Yarick-Workshop/Walking-Dog-4-Paws/Dog-Utils.scad

module screw_hole(height, diameter, delta)
{
    cylinder(h = height + delta, d = diameter, center = true, $fn=360);
}
