Yarick-Workshop/Walking-Dog-4-Paws/(commit log)

2023-12-01 Removed all debug parts from the medium one (in the coordinates of the "paw-wheels")
    [Dog.scad]
2023-12-04 Added wheel spacers
    [Dog.scad]
2023-12-05 Hidden screw headers and nuts for wheel-paws shafts
    [Dog.scad]
2023-12-07 - Added screw nuts grooves (just on the right side – there will be grooves for screw heads on the left side); - Refactored logging of debug information; - Adjusted some argument values(screw header d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
    [Dog.scad]
2023-12-08 Added Producing type of rendering. There are two types: Preview and Producing. It is customizable by parameters
    [Dog.scad]
2023-12-12 Added test figures for testing customization of shaft diameter, screw nuts and headers. The figure is visible in "Producing" mode only
    [Dog.scad]
2023-12-16 Sizing adjustment for M3 screws and nuts & Solved problem of overheating test figures
    [Dog.scad]
2023-12-18 Sizing adjustment for M3 screws, nuts and shaft diameter
    [Dog.scad]
2023-12-18 Final (hope so) screw & shaft diameters adjustment
    [Dog.scad]
2023-12-25 Increased wheel spacer wall thickness, and added logging it's result value
    [Dog.scad]
2023-12-27 Enforced thin parts of the middle
    [Dog.scad]
2024-02-06 Wheel width is calculated from spacer and medium part (allow to have the wide wheels)
    [Dog.scad]
2024-02-06 Get rid of most relative Units of measure
    [Dog.scad]
2024-02-06 Added "Wheel width" and "Screw rod length" to debugging log; Refined debugging log in YAML-like style
    [Dog.scad]
2024-02-08 Wheel spacer is rendered in Producing mode just in case showWheels = true
    [Dog.scad]
2024-02-08 Adjusted hole sizes (for screws and shafts)
    [Dog.scad]
2024-02-08 Get rid of artifacts on preview for the wheel shaft customization figure
    [Dog.scad]
2024-02-08 Reduce filament usage for test figures
    [Dog.scad]
2024-02-09 Rounded values (except constants and adjustments) to xx.x
    [Dog.scad]
2024-02-10 Fixed wheel slicing problem with Prusa Slicer (a wheel with a built spacer was separating into 2 parts: spacer and wheel)
    [Dog.scad]
2024-02-22 Added assembly documentation to README.md
2024-02-24 Update README.md
    Added "Gel pen refill" info and ⌀ s
2024-02-27 Update README.md
    Added references to Prerendered STL-s on Thingiverse
2024-03-06 Added Side and Medium parts roundings with Cone and Sphere (With Minkowski)
    [Dog.scad]
2024-03-08 Increased convexity to have less artefacts; Added model rotating for Animation
    [Dog.scad]
2024-03-08 Possible to set currentHeight = 0
    [Dog.scad]
2024-03-15 Fixed mounting coords Xs for rounded model; Default rounding radius = 2.0.
    [Dog.scad]
2024-03-15 Fied formatting for mounting coords
    [Dog.scad]
2024-03-18 README.md: Added PTFE tube; Fixed drill bit info and filament amount
2024-04-19 Extracted Paws-Wheels related logic to an external library
    [Dog-Paw-Library.scad, Dog.scad]
2024-04-19 Extracted the medium part related logic to an external library
    [Dog-Medium-Library.scad, Dog.scad]
2024-04-19 Converted Dog-Paw-Library to a context independent module
    [Dog-Paw-Library.scad, Dog.scad]
2024-04-19 Fixed hiding Paws in Preview mode
    [Dog.scad]
2024-04-19 Converted Dog-Medium-Library to a context independent module
    [Dog-Medium-Library.scad, Dog-Utils.scad, Dog.scad]
2024-06-21 Added a Clutch to a Paw
    [Dog-Paw-Library.scad, Dog.scad]
2024-06-21 Fixed assembled wheel in "Preview" mode
    [Dog-Paw-Library.scad, Dog.scad]
2024-06-21 Removed preset with Wide Paws (they are by-default); Optimized wheels and medium parts
    [Dog.scad]
2024-06-21 Medium separated into 3 parts for printing with different colors
    [Dog-Medium-Library.scad, Dog.scad]
2024-06-21 Polished parameters
    [Dog.scad]
2024-06-22 Refactoring: get rid of duplications for wheels and medium parts
    [Dog-Paw-Library.scad, Dog.scad]
2024-06-22 Added all needed parts to "Producing" mode
    [Dog.scad]
2024-06-22 Added offset between clutch feet
    [Dog-Paw-Library.scad, Dog.scad]
2024-06-25 Increased distances between parts of the model for "Producing" mode
    [Dog.scad]
2024-07-06 Wheels are connected with tenon joints
    [Dog-Paw-Library.scad, Dog.scad]
2024-07-09 Fixed tenon offset
    [Dog.scad]
2024-08-26 Added "Demo" rendering type parameter (3 dogs with all possible type of roundings)
    [Dog.scad]
2024-08-26 Fixed rendering sides in Demo mode
    [Dog.scad]
2024-09-12 Fixed README.md: Added link to assembly video on Telegram; Fixed typos; Changed header; Polished
