Yarick-Workshop/Walking-Dog-4-Paws/(notices)

Notices in the files:
README.md:
CC BY-NC-SA 4.0
